ema-rauf/Study-Air-Station/BOM.csv

Item | Qty | Supplier | Cost/item | Total Cost | link
ESP32 DevKit V1 (30 pin) | 1 | Ali express | $6.00 | $6.00 | https://www.aliexpress.com/item/1005005692090880.html
SCD40 CO2 sensor module | 1 | Ali express | $20.00 | $20.00 | https://www.aliexpress.com/item/1005002905505683.html
PMS5003 particle sensor | 1 | Ali express | $18.00 | $18.00 | https://www.aliexpress.com/item/1005002073309250.html
2.0 inch ST7789 TFT 240x320 | 1 | Ali express | $6.00 | $6.00 | https://www.aliexpress.com/item/1005004237117445.html
microSD SPI module | 1 | Ali express | $1.50 | $1.50 | https://www.aliexpress.com/item/32787679017.html
microSD card 8 GB | 1 | Ali express | $4.00 | $4.00 | https://www.aliexpress.com/ssr/300000512/BundleDeals2?productIds=1005012294264996:12000057978617583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
5V fan 25x25x10 mm | 1 | Ali express | $2.00 | $2.00 | https://www.aliexpress.com/item/33030471365.html?gatewayAdapt=usa2glo4itemAdapt
IRLZ44N MOSFET | 1 | Ali express | $1.00 | $1.00 | https://www.aliexpress.com/i/32714396199.html
1N5819 Schottky diode | 2 | Ali express | $0.20 | $0.40 | https://www.aliexpress.com/item/1005005539516519.html?gatewayAdapt=deu2glo
470 uF 10 V capacitor | 1 | Ali express | $0.30 | $0.30 | https://www.aliexpress.com/item/32812085542.html
100 nF ceramic capacitor | 3 | Ali express | $0.10 | $0.30 | https://www.aliexpress.com/item/32429917283.html
Resistors (100R, 220R, 10k) | 1 | Ali express | $1.00 | $1.00 | https://www.aliexpress.com/item/1005002994755806.html
5 mm RGB LED, common cathode | 1 | Ali Express | $2.00 | $2.00 | https://www.aliexpress.com/item/32601543257.html
Active buzzer 12 mm | 1 | Ali Express | $0.80 | $0.80 | https://www.aliexpress.com/item/1005003147484678.html
Tactile switch 6x6x13 mm | 2 | Ali Express | $0.30 | $0.60 | https://www.aliexpress.com/i/1005003158690193.html?gatewayAdapt=4itemAdapt
Screw terminal 2 pin 5.08 mm | 2 | Ali Express | $0.50 | $1.00 | https://www.aliexpress.com/item/1005003331913171.html
Pin header and socket kit | 1 | Ali Express | $1.50 | $1.50 | https://www.aliexpress.com/item/4000873858801.html?gatewayAdapt=usa2glo4itemAdapt
Dupont jumper wires F-F 20 cm | 1 | Ali Express | $2.00 | $2.00 | https://www.aliexpress.com/item/1601497272.html?gatewayAdapt=usa2glo4itemAdapt
M3 screw and standoff set | 2 | Ali Express | $1.00 | $2.00 | https://www.aliexpress.com/item/32645948444.html
5V 2A power adapter | 1 | Ali Express | $3.00 | $3.00 | https://www.aliexpress.com/item/1005003782554415.html?gatewayAdapt=usa2glo4itemAdapt
PCB, 5 pcs, 100x80 mm 2 layer | 1 | JLCPCB | $5.00 | $5.00 | https://jlcpcb.com/
3D printed case, base and lid | 1 | JLCPCB | $12.00 | $12.00 | https://jlc3dp.com/
Estimated total shipping | 1 |  |  | $20.00
