ema-rauf/Study-Air-Station/cad/air_station_case.step

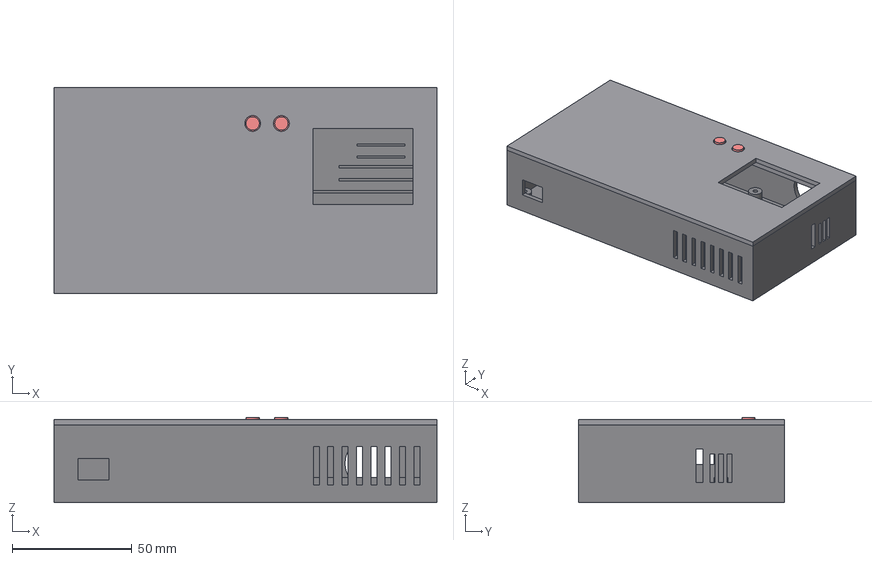
[picture p7: CAD file, 2026-11-08]
cad/air_station_case.step
160.0 x 86.0 x 35.6 mm
base
lid
button_cap_1
button_cap_2
