ema-rauf/Study-Air-Station/hardware/air_station.kicad_pcb

## KiCad design hardware/air_station.kicad_pcb (2026-11-08)

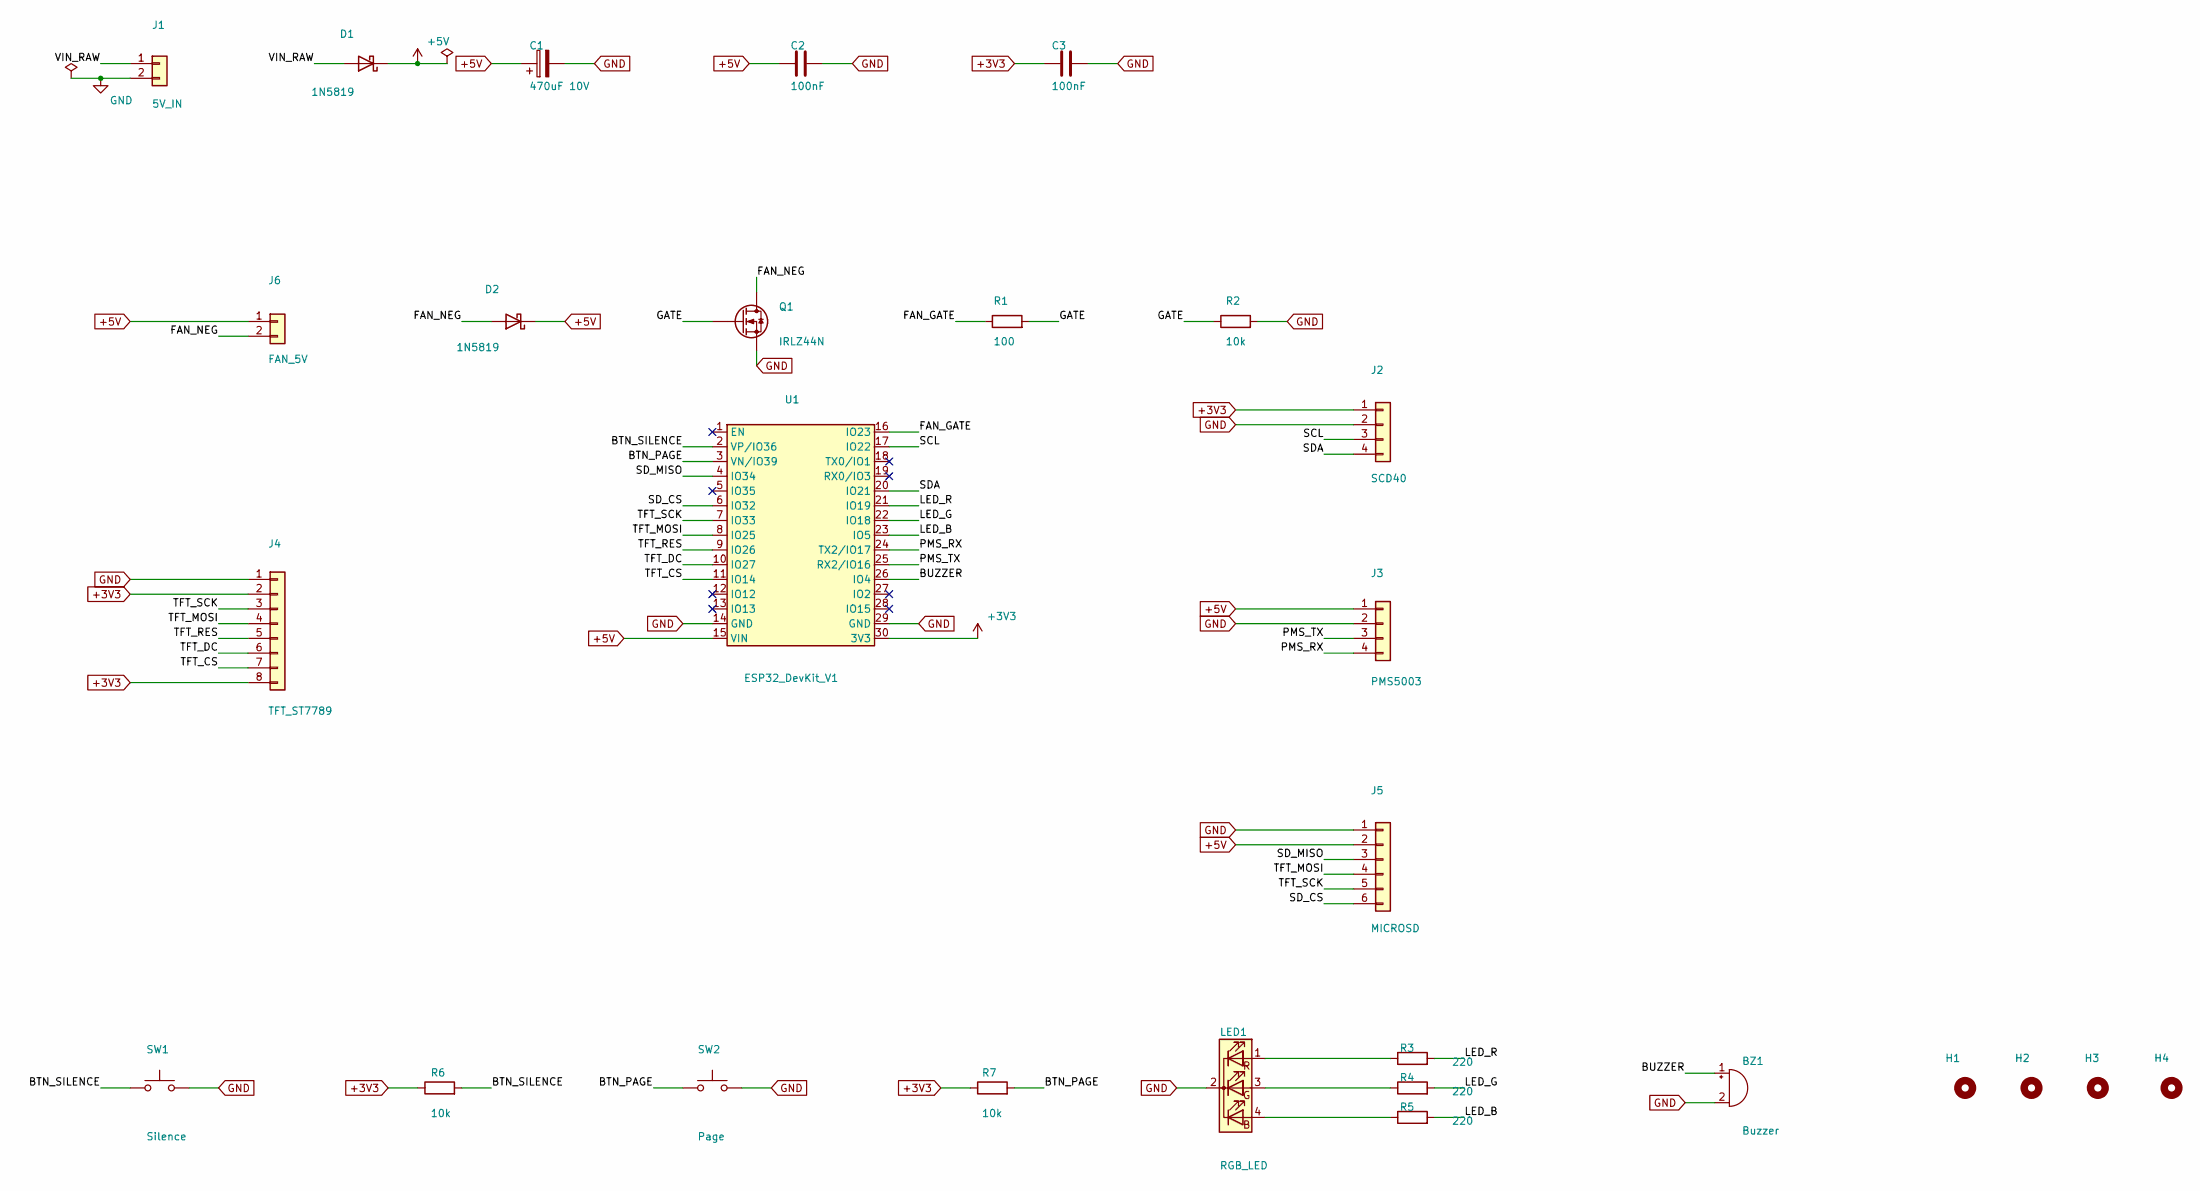
[picture p8: schematic air_station.kicad_sch, Study Air Station]

Parts:
BZ1: Buzzer; Buzzer_12x9.5RM7.6
C1: 470uF 10V; CP_Radial_D8.0mm_P3.50mm
C2, C3: 100nF; C_Disc_D5.0mm_W2.5mm_P5.00mm
D1, D2: 1N5819; D_DO-41_SOD81_P10.16mm_Horizontal
H1, H2, H3, H4: MountingHole_3.2mm; MountingHole_3.2mm_M3
J1: 5V_IN; TerminalBlock_Phoenix_MKDS-1,5-2-5.08_1x02_P5.08mm_Horizont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
J2: SCD40; PinHeader_1x04_P2.54mm_Vertical
J3: PMS5003; PinHeader_1x04_P2.54mm_Vertical
J4: TFT_ST7789; PinHeader_1x08_P2.54mm_Vertical
J5: MICROSD; PinHeader_1x06_P2.54mm_Vertical
J6: FAN_5V; TerminalBlock_Phoenix_MKDS-1,5-2-5.08_1x02_P5.08mm_Horizont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
LED1: RGB_LED; LED_D5.0mm-4_RGB_Wide
Q1: IRLZ44N; TO-220-3_Vertical
R1: 100; R_Axial_DIN0204_L3.6mm_D1.6mm_P5.08mm_Horizontal
R2, R6, R7: 10k; R_Axial_DIN0204_L3.6mm_D1.6mm_P5.08mm_Horizontal
R3, R4, R5: 220; R_Axial_DIN0204_L3.6mm_D1.6mm_P5.08mm_Horizontal
SW1: Silence; SW_Tactile_6mm_Diagonal
SW2: Page; SW_Tactile_6mm_Diagonal
U1: ESP32_DevKit_V1; ESP32_DevKit_V1_30pin_Socket

Connections:
+3V3: C3.1, J2.1, J4.2, J4.8, R6.1, R7.1, U1.30 (3V3)
+5V: C1.1, C2.1, D1.1 (K), D2.1 (K), J3.1, J5.2, J6.1, U1.15 (VIN)
/BTN_PAGE: R7.2, SW2.1, U1.3 (VN/IO39)
/BTN_SILENCE: R6.2, SW1.1, U1.2 (VP/IO36)
/BUZZER: BZ1.1 (+), U1.26 (IO4)
/FAN_GATE: R1.1, U1.16 (IO23)
/FAN_NEG: D2.2 (A), J6.2, Q1.2 (D)
/GATE: Q1.1 (G), R1.2, R2.1
/LED_B: R5.2, U1.23 (IO5)
/LED_G: R4.2, U1.22 (IO18)
/LED_R: R3.2, U1.21 (IO19)
/PMS_RX: J3.4, U1.24 (TX2/IO17)
/PMS_TX: J3.3, U1.25 (RX2/IO16)
/SCL: J2.3, U1.17 (IO22)
/SDA: J2.4, U1.20 (IO21)
/SD_CS: J5.6, U1.6 (IO32)
/SD_MISO: J5.3, U1.4 (IO34)
/TFT_CS: J4.7, U1.11 (IO14)
/TFT_DC: J4.6, U1.10 (IO27)
/TFT_MOSI: J4.4, J5.4, U1.8 (IO25)
/TFT_RES: J4.5, U1.9 (IO26)
/TFT_SCK: J4.3, J5.5, U1.7 (IO33)
/VIN_RAW: D1.2 (A), J1.1
GND: BZ1.2 (-), C1.2, C2.2, C3.2, J1.2, J2.2, J3.2, J4.1, J5.1, LED1.2 (K), Q1.3 (S), R2.2, SW1.2, SW2.2, U1.14 (GND), U1.29 (GND)
unnamed: LED1.4 (B), R5.1
unnamed: LED1.3 (G), R4.1
unnamed: LED1.1 (R), R3.1

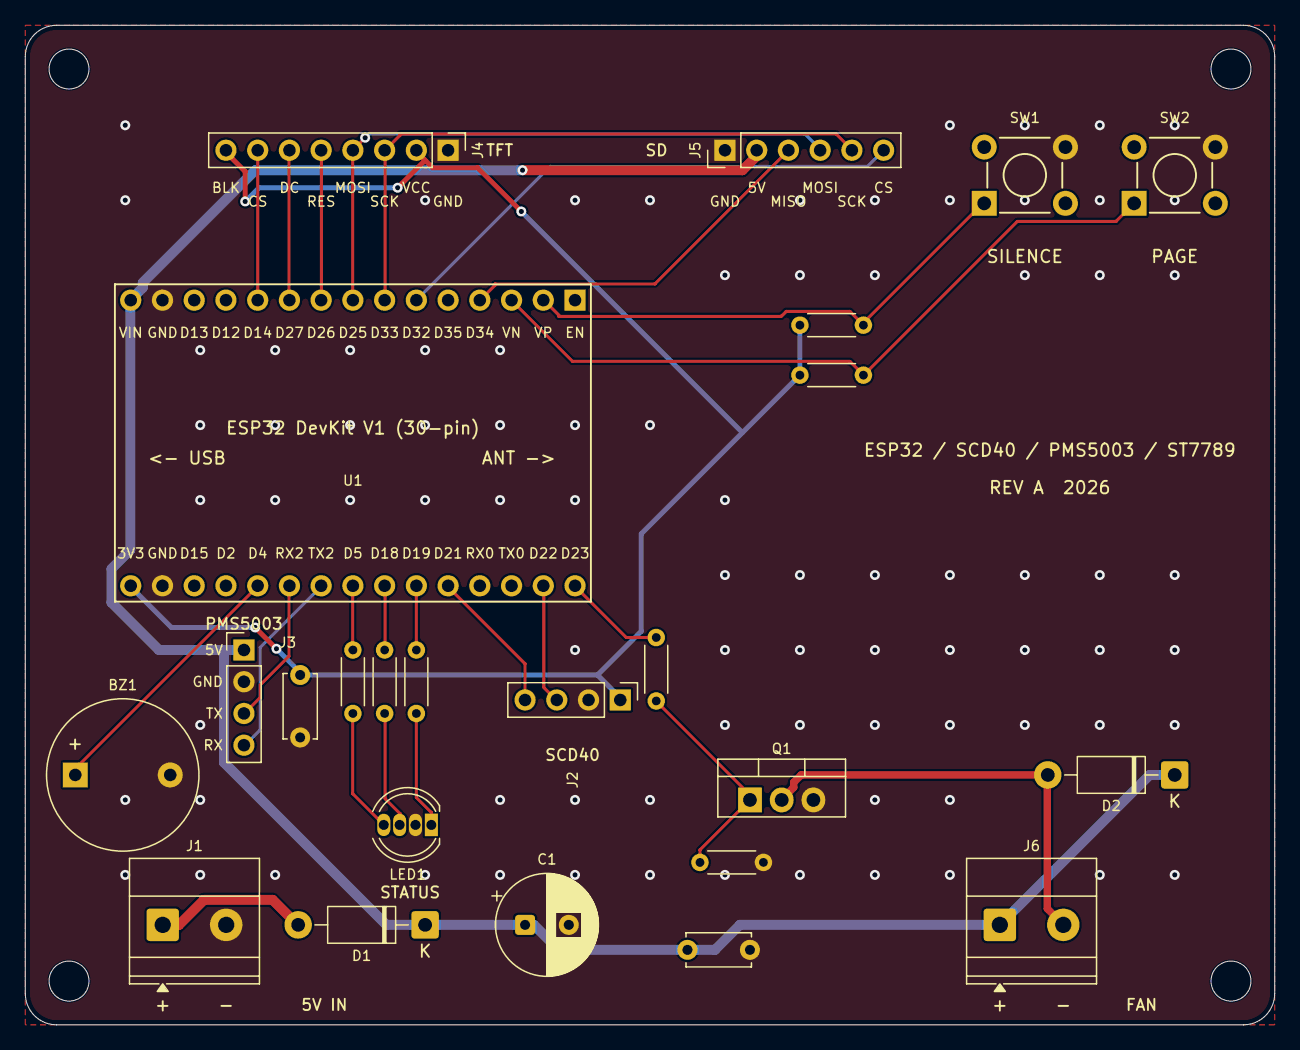
[picture p9: board air_station.kicad_pcb from above]

Board: 2 copper layers, 100.0 x 80.0 mm, 28 parts (0 on the bottom side), 27 nets.
