ema-rauf/Study-Air-Station/(commit log)

2026-11-08 Sync Study Air Station from Half Life
    [BOM.csv]
2026-11-08 Study Air Station
    [BOM.csv, air_station.kicad_pcb, air_station.kicad_sch, air_station_case.step]
2026-11-08 Update text
    [air_station.kicad_pcb, air_station.kicad_sch]
2026-11-08 Ignore local KiCad state
2026-11-08 Ignore KiCad lock files
2026-11-08 Restore BOM
    [BOM.csv]
2026-11-08 Fix button struct order for Arduino build
    [air_station.ino]
2026-11-08 Update BOM links
    [BOM.csv]
